krzychoooo/Mercury_PCB_Inputx5_V100/img/Input_V1_0_0.png

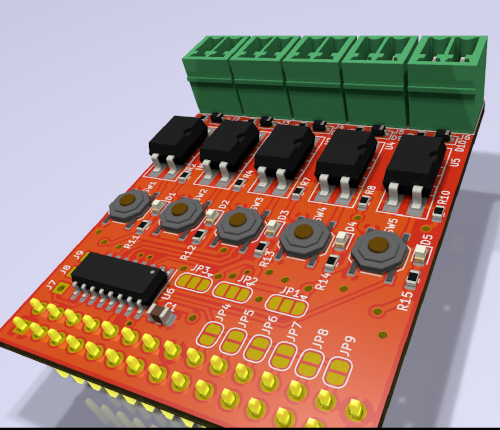
img/Input_V1_0_0.png
