krzychoooo/Mercury_PCB_Inputx5_V100/Doc/Input_V1_0_0.pdf

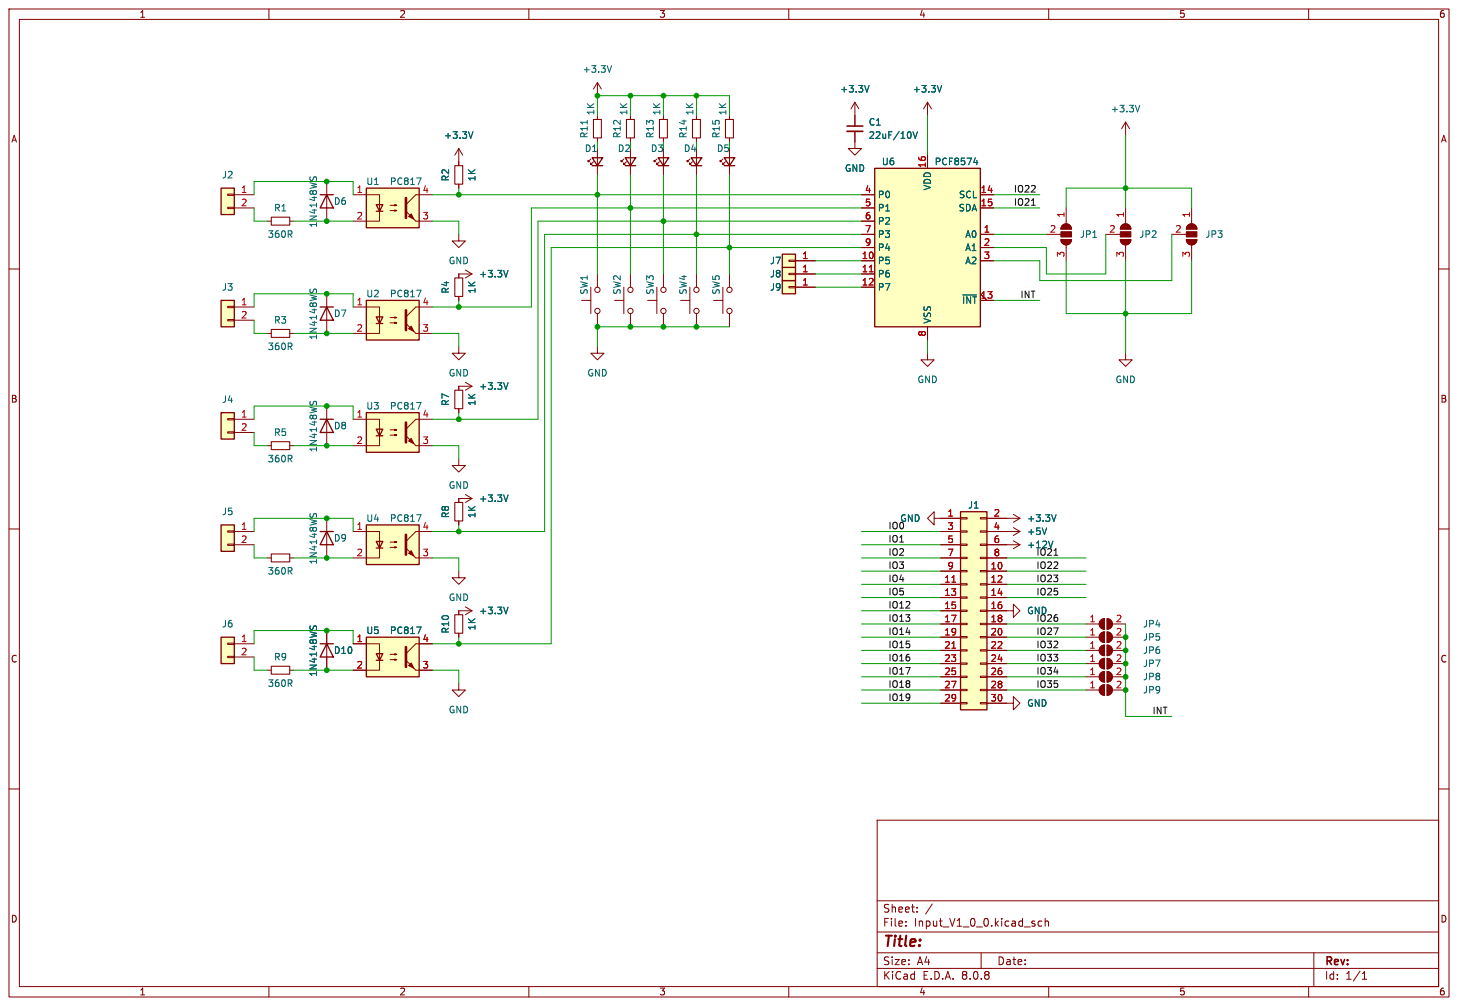
[picture p6: page 1]

Id: 1/1 Title: File: Input_V1_0_0.kicad_sch Sheet: /
