krzychoooo/Mercury_PCB_Inputx5_V100/Input_V1_0_0.kicad_sch

## KiCad design Input_V1_0_0.kicad_sch (2025-10-06)

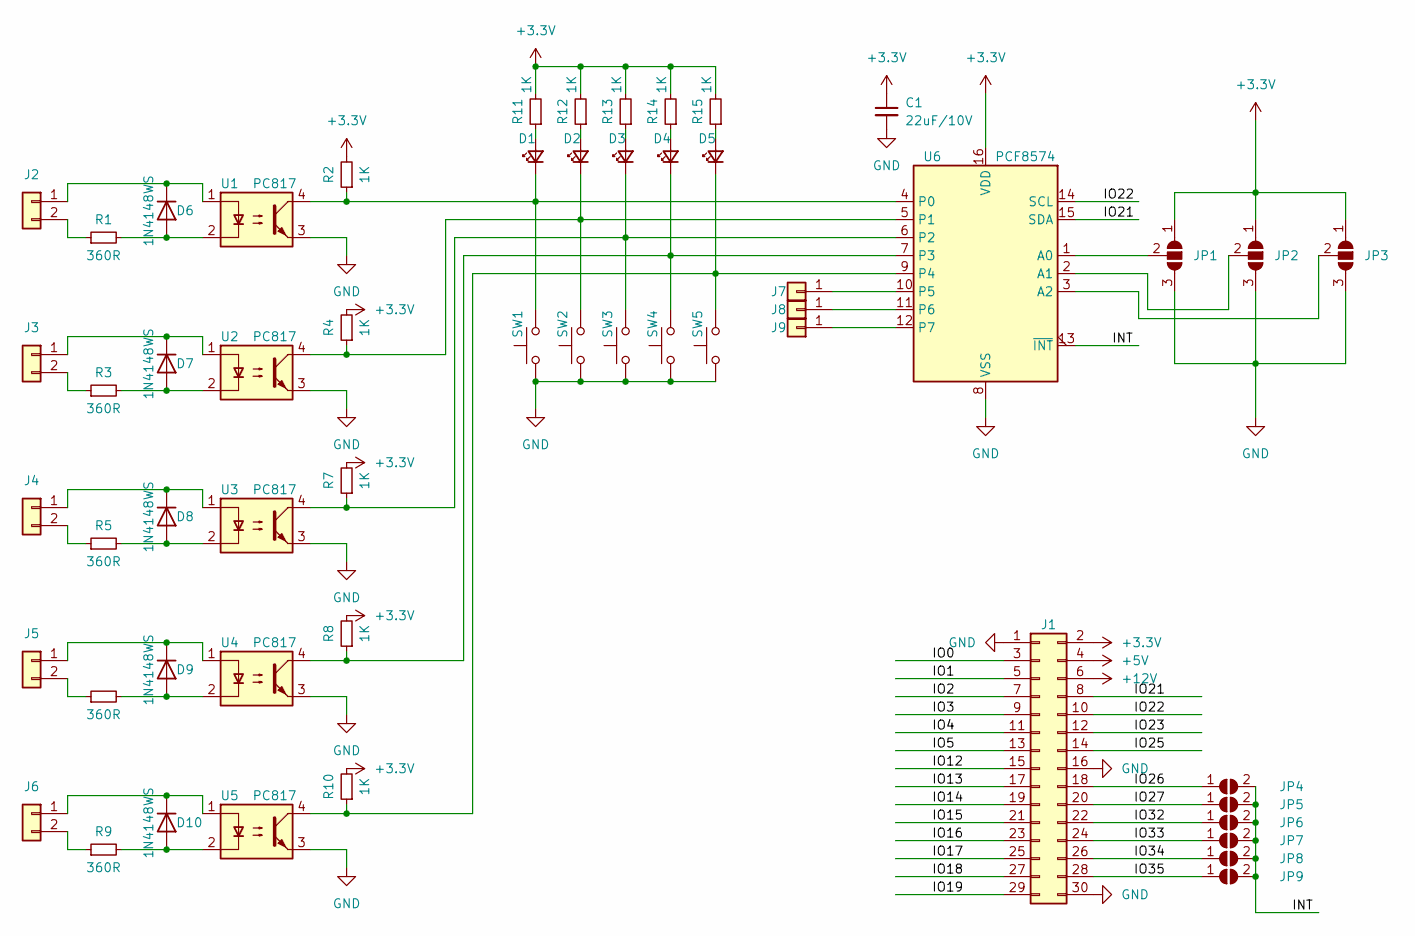
[picture p7: schematic Input_V1_0_0.kicad_sch]

Parts:
C1: 22uF/10V; C_0805_2012Metric; LCSC part# C45783
D1, D2, D3, D4, D5: LED_Small; LED_0603_1608Metric; LCSC part# C2286
D6, D7, D8, D9, D10: 1N4148WS; D_SOD-323; LCSC part# C2128
J1: Conn_02x15_Odd_Even; Pin_Header_02x15_mirror
J2, J3, J4, J5, J6: Conn_01x02; MX15EDGVC-3.5-02P-GN01-Cu-A; LCSC part# C5188318
J7, J8, J9: Conn_01x01; Pin_Header_1x01_vertical
JP1, JP2, JP3: SolderJumper_3_Open; SolderJumper-3_P1.3mm_Open_RoundedPad1.0x1.5mm
JP4, JP5, JP6, JP7, JP8, JP9: SolderJumper_2_Open; SolderJumper-2_P1.3mm_Open_RoundedPad1.0x1.5mm
R1, R3, R5, R6, R9: 360R; R_0603_1608Metric; LCSC part# C23151
R2, R4, R7, R8, R10: 1K; R_0603_1608Metric; LCSC part# C21190
R11, R12, R13, R14, R15: 1K; R_0603_1608Metric; LCSC part# C22765
SW1, SW2, SW3, SW4, SW5: SW_Push; SW_Push_1P1T_XKB_TS-1187A; LCSC part# C318884
U1, U2, U3, U4, U5: PC817; DIP-4_W8.89mm_SMDSocket_LongPads; LCSC part# C5451663
U6: PCF8574; SOP-16_3.9x9.9mm_P1.27mm; LCSC part# C5310792

Connections:
+3.3V: C1.1, J1.2, JP1.1 (A), JP2.1 (A), JP3.1 (A), R2.2, R4.2, R7.2, R8.2, R10.2, R11.2, R12.2, R13.2, R14.2, R15.2, U6.16 (VDD)
+5V: J1.4
+12V: J1.6
GND: C1.2, J1.1, J1.16, J1.30, JP1.3 (B), JP2.3 (B), JP3.3 (B), SW1.1, SW2.1, SW3.1, SW4.1, SW5.1, U1.3, U2.3, U3.3, U4.3, U5.3, U6.8 (VSS)
INT: JP4.2 (B), JP5.2 (B), JP6.2 (B), JP7.2 (B), JP8.2 (B), JP9.2 (B), U6.13 (~INT)
IO0: J1.3
IO1: J1.5
IO2: J1.7
IO3: J1.9
IO4: J1.11
IO5: J1.13
IO12: J1.15
IO13: J1.17
IO14: J1.19
IO15: J1.21
IO16: J1.23
IO17: J1.25
IO18: J1.27
IO19: J1.29
IO21: J1.8, U6.15 (SDA)
IO22: J1.10, U6.14 (SCL)
IO23: J1.12
IO25: J1.14
IO26: J1.18, JP4.1 (A)
IO27: J1.20, JP5.1 (A)
IO32: J1.22, JP6.1 (A)
IO33: J1.24, JP7.1 (A)
IO34: J1.26, JP8.1 (A)
IO35: J1.28, JP9.1 (A)
unnamed: D1.1 (K), R2.1, SW1.2, U1.4, U6.4 (P0)
unnamed: D1.2 (A), R11.1
unnamed: D2.1 (K), R4.1, SW2.2, U2.4, U6.5 (P1)
unnamed: D2.2 (A), R12.1
unnamed: D3.1 (K), R7.1, SW3.2, U3.4, U6.6 (P2)
unnamed: D3.2 (A), R13.1
unnamed: D4.1 (K), R8.1, SW4.2, U4.4, U6.7 (P3)
unnamed: D4.2 (A), R14.1
unnamed: D5.1 (K), R10.1, SW5.2, U5.4, U6.9 (P4)
unnamed: D5.2 (A), R15.1
unnamed: D6.1 (K), J2.1, U1.1
unnamed: D6.2 (A), R1.2, U1.2
unnamed: D7.1 (K), J3.1, U2.1
unnamed: D7.2 (A), R3.2, U2.2
unnamed: D8.1 (K), J4.1, U3.1
unnamed: D8.2 (A), R5.2, U3.2
unnamed: D9.1 (K), J5.1, U4.1
unnamed: D9.2 (A), R6.2, U4.2
unnamed: D10.1 (K), J6.1, U5.1
unnamed: D10.2 (A), R9.2, U5.2
unnamed: J2.2, R1.1
unnamed: J3.2, R3.1
unnamed: J4.2, R5.1
unnamed: J5.2, R6.1
unnamed: J6.2, R9.1
unnamed: J7.1, U6.10 (P5)
unnamed: J8.1, U6.11 (P6)
unnamed: J9.1, U6.12 (P7)
unnamed: JP1.2 (C), U6.1 (A0)
unnamed: JP2.2 (C), U6.2 (A1)
unnamed: JP3.2 (C), U6.3 (A2)
